mkgeiger/geiger-counter-iot/highvoltage.sch

## EAGLE design highvoltage.sch (2019-03-01, last stored version)

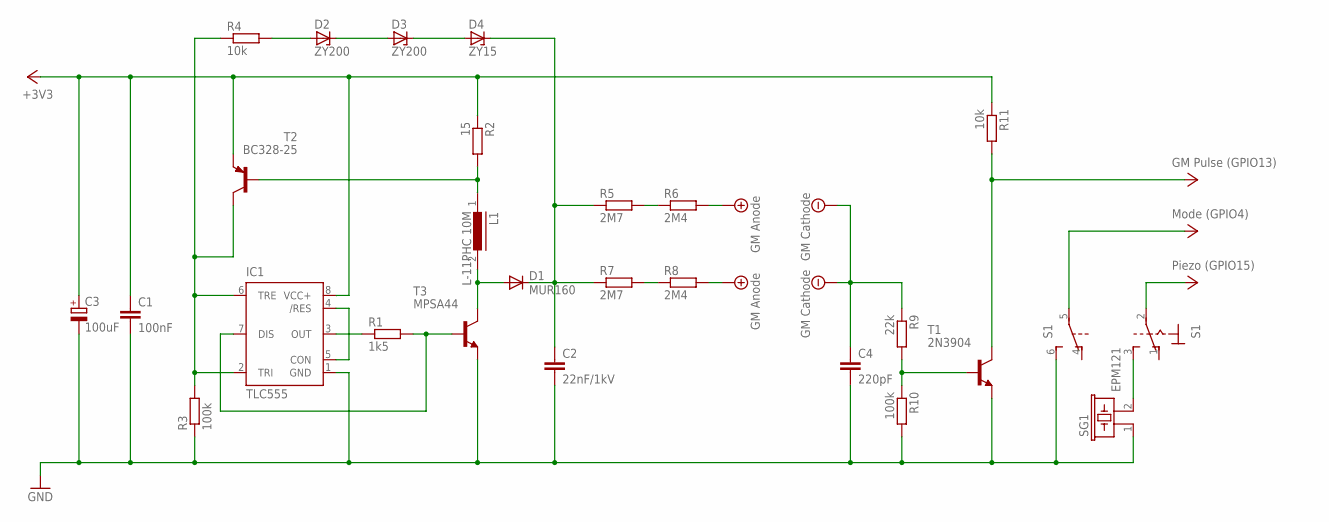
[picture p9: schematic highvoltage.sch]

Parts:
C1: 100nF; C2.5-2
C2: 22nF/1kV; C15B5
C3: 100uF; E2-5
C4: 220pF; C7.5B3
D1: MUR160; DO41-10
D2, D3: ZY200; P1Z12
D4: ZY15; DO13M
IC1: TLC555; DIL-08
L1: L-11PHC 10M; 82114R
R1: 1k5; 0204/7
R2: 15; 0204/7
R3, R10: 100k; 0204/7
R4, R11: 10k; 0204/7
R5, R7: 2M7; 0204/7
R6, R8: 2M4; 0204/7
R9: 22k; 0204/7
S1: 320-938
SG1: EPM121; EFBAA40D101
T1: 2N3904; TO92
T2: BC328-25; TO92-EBC
T3: MPSA44; TO92-EBC

Connections:
+3V3: C1.1, C3.+, IC1.8 (VCC+), R2.1, R11.1, R11.2, S1.2, T1.1 (C), T2.E
+UB: R6.2, R8.2
-UB: C4.1, R9.1
GND: C1.2, C2.2, C3.-, C4.2, IC1.1 (GND), R3.1, R10.2, S1.6 (S), SG1.1, T1.3 (E), T3.E
unnamed: D1.A, L1.2, T3.C
unnamed: IC1.3 (OUT), R1.1
unnamed: IC1.7 (DIS), R1.2, T3.B
unnamed: IC1.4 (/RES), IC1.5 (CON)
unnamed: L1.1, R2.2, T2.B
unnamed: IC1.2 (TRI), IC1.6 (TRE), R3.2, R4.1, T2.C
unnamed: S1.3 (S), SG1.2
unnamed: R9.2, R10.1, T1.2 (B)
unnamed: D2.A, R4.2
unnamed: D2.C, D3.A
unnamed: D3.C, D4.A
unnamed: C2.1, D1.C, D4.C, R5.1, R7.1
unnamed: R5.2, R6.1
unnamed: R7.2, R8.1
