mkgeiger/geiger-counter-iot/(commit log)

2019-03-01 Initial Release
    [geigerdata.ods, highvoltage.sch]
2019-03-02 Restructured for GitHub
    [geigerdata.ods, highvoltage.sch]
2019-03-05 source code moved because of Arduino IDE wish
2019-03-07 bugfix for logging data format
    [GeigerCounter.ino]
